boneycircuitry/megamega2612/documentation/megamega2612schematic.pdf

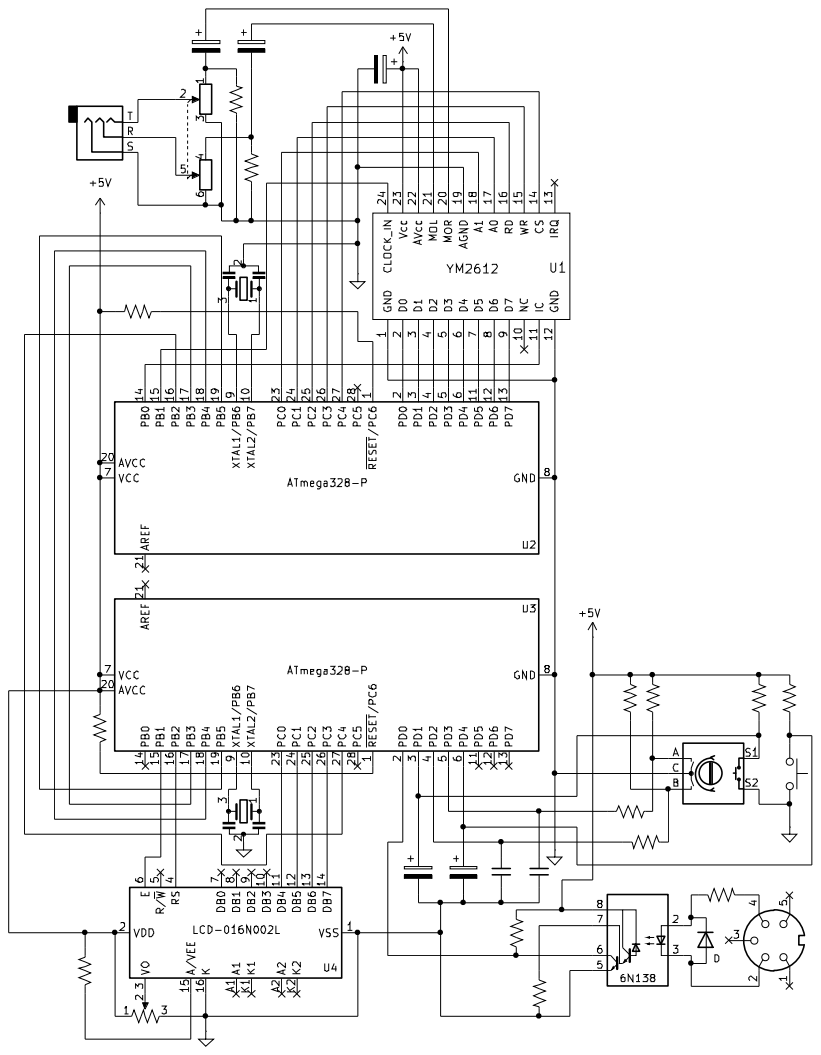
[picture p1: page 1]
