boneycircuitry/megamega2612/megamega1/defines.h

/*
 ----------------------------------------------------------------------------
 * "THE BEER-WARE LICENSE" (Revision 42):
 * <chazwilmot@gmail.com> & <tristjpawlenty@gmail.com> wrote and adapted this file.  
 * As long as you retain this notice you can do whatever you want with this stuff. 
 * If we meet some day, and you think this stuff is worth it, you can buy me a beer.
 *                                          Charles Wilmot and Tristan Pawlenty
 * ----------------------------------------------------------------------------
 * ----------------------------------------------------------------------------
 * "THE BEER-WARE LICENSE" (Revision 42):
 * <joerg@FreeBSD.ORG> wrote this file.  As long as you retain this notice you
 * can do whatever you want with this stuff. If we meet some day, and you think
 * this stuff is worth it, you can buy me a beer in return.        Joerg Wunsch
 * ----------------------------------------------------------------------------
 *
 * General stdiodemo defines
 *
 * Replace X and Y with your defintions based on your hardware
 *
 * $Id$
 */

/* CPU frequency */
#define F_CPU 16000000UL   // define your CPU Frequency

/* UART baud rate */
#define UART_BAUD  31250UL   // define your UART baud rate

/* HD44780 LCD port connections */
#define HD44780_RS B, 1   // X = PORT Name | Y = PORT number
#define HD44780_RW B, 0   // X = PORT Name | Y = PORT number
#define HD44780_E  B, 2   // X = PORT Name | Y = PORT number
/* The data bits have to be not only in ascending order but also consecutive. */
#define HD44780_D4 C, 0   // X = PORT Name | Y = PORT number

/* Whether to read the busy flag, or fall back to
   worst-time delays. */
#define USE_BUSY_BIT 0
